haiha-ux/pcb-sample-preamp/renders/pcb_3d_bottom.png

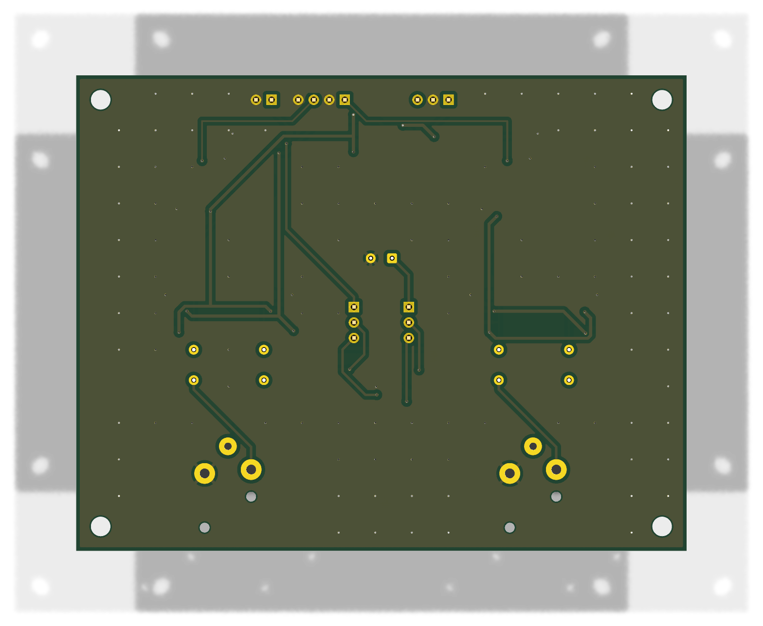
renders/pcb_3d_bottom.png
