haiha-ux/pcb-sample-preamp/renders/pcb_3d_top.png

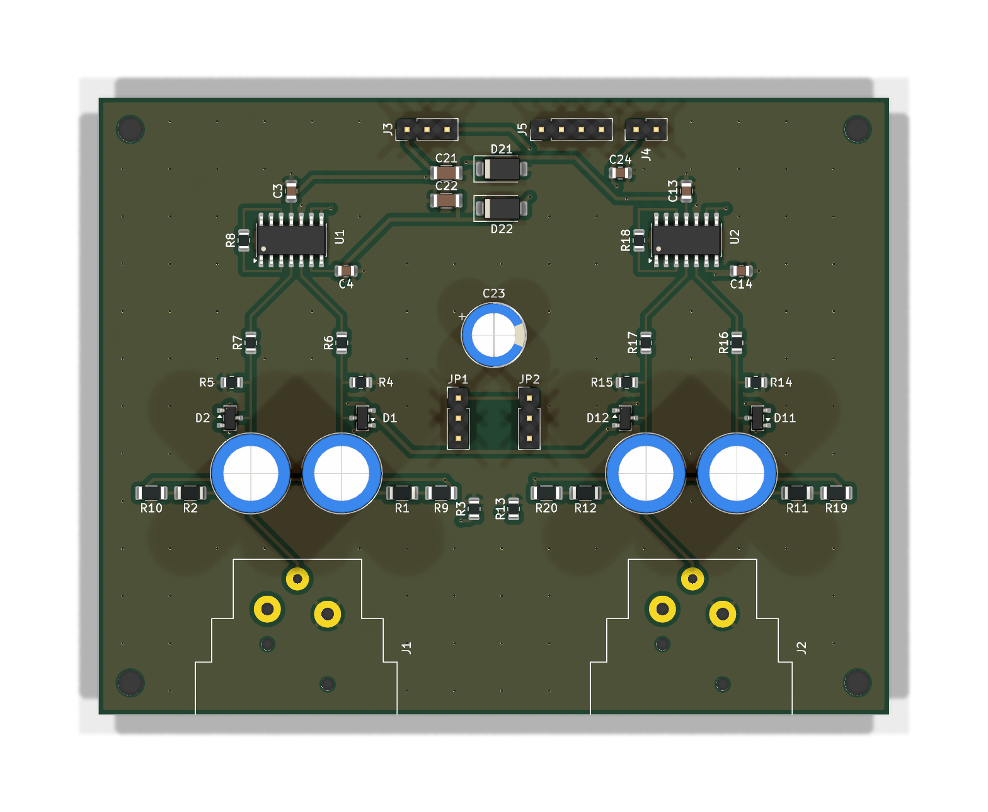
renders/pcb_3d_top.png
