haiha-ux/pcb-sample-preamp/fab/mic_preamp_2ch-BOM.csv

Designator | Value | Footprint | Manufacturer | MPN | LCSC | Spec | Qty
C1,C2,C11,C12 | 47u 63V NP | Capacitor_THT:C_Radial_D10.0mm_H20.0mm_P5.00mm | Nichicon | UVP1J470MPD | not stocked (DigiKey) | 47uF 63V bi-polar D10x17.5 P5.0; alt Cornell Dubilier 476BPS063M | 4
C3,C4,C13,C14 | 100n | Capacitor_SMD:C_0805_2012Metric | YAGEO | CC0805KRX7R9BB104 | C49678 | 100nF 50V X7R 0805 | 4
C21,C22 | 10u 25V | Capacitor_SMD:C_1206_3216Metric | Samsung Electro-Mechanics | CL31B106KAHNNNE | C14860 | 10uF 25V X7R 1206 | 2
C23 | 47u 100V | Capacitor_THT:CP_Radial_D8.0mm_P3.50mm | NJCON | 4701010812R00 | C5373423 | 47uF 100V D8x12 P3.5 | 1
C24 | 100n 100V | Capacitor_SMD:C_0805_2012Metric | Samsung Electro-Mechanics | CL21B104KCFNNNE | C28233 | 100nF 100V X7R 0805 | 1
D1,D2,D11,D12 | BAV99 | Package_TO_SOT_SMD:SOT-23 | Nexperia | BAV99,215 | C2500 |  | 4
D21,D22 | SMAJ16A | Diode_SMD:D_SMA | Littelfuse | SMAJ16A | C74561 | TVS 16V standoff, 26V clamp, 400W, rail clamp for P48 hot-plug | 2
H1-H4 | M3 | MountingHole:MountingHole_3.2mm_M3 |  |  |  |  | 4
J1,J2 | NC3FAH1 | Connector_Audio:Jack_XLR_Neutrik_NC3FAH1_Horizontal | Neutrik | NC3FAH1 | C368476 |  | 2
J3 | PWR +15/GND/-15 | Connector_PinHeader_2.54mm:PinHeader_1x03_P2.54mm_Vertical | Molex | 22284030 | C587036 |  | 1
J4 | P48 +48/GND | Connector_PinHeader_2.54mm:PinHeader_1x02_P2.54mm_Vertical | Molex | 22284020 | C234182 |  | 1
J5 | OUT1/GND/OUT2/GND | Connector_PinHeader_2.54mm:PinHeader_1x04_P2.54mm_Vertical | Molex | 22284040 | C587039 |  | 1
JP1,JP2 | P48 ON=1-2 OFF=2-3 | Connector_PinHeader_2.54mm:PinHeader_1x03_P2.54mm_Vertical | Molex | 22284030 | C587036 | 1x3 2.54mm 500V + shunt Sullins SPC02SYAN (LCSC C6297395) | 2
R1,R2,R9-R12,R19,R20 | 3.40k | Resistor_SMD:R_1206_3216Metric | YAGEO | RT1206BRD073K4L | C870711 | 3.40k 0.1% 25ppm thin film 1206 0.25W 200V; 2 in series per leg = 6.80k | 8
R3,R13 | 47k | Resistor_SMD:R_0805_2012Metric | UNI-ROYAL | 0805W8F4702T5E | C17713 | 47k 1% 0805 150V | 2
R4,R5,R14,R15 | 2.2k | Resistor_SMD:R_0805_2012Metric | YAGEO | RT0805BRD072K2L | C865371 | 2.2k 0.1% 25ppm thin film 0805 | 4
R6,R7,R16,R17 | 10R | Resistor_SMD:R_0805_2012Metric | SIE | CRF0805Q10R0BN | C55205321 | 10R 0.1% thin film 0805 | 4
R8,R18 | 60.4R | Resistor_SMD:R_0805_2012Metric | FOJAN | FRC0805F60R4TS | C2933479 | 60.4R 1% 0805 (G=100) | 2
U1,U2 | INA163UA | Package_SO:SOIC-14_3.9x8.7mm_P1.27mm | Texas Instruments | INA163UA | C2868965 |  | 2
