haiha-ux/pcb-sample-preamp/(list of files, drawings)

Other design files:
reports/route.dsn
