haiha-ux/pcb-sample-preamp/mic_preamp_2ch.kicad_pcb

## KiCad design mic_preamp_2ch.kicad_pcb (2026-10-30)

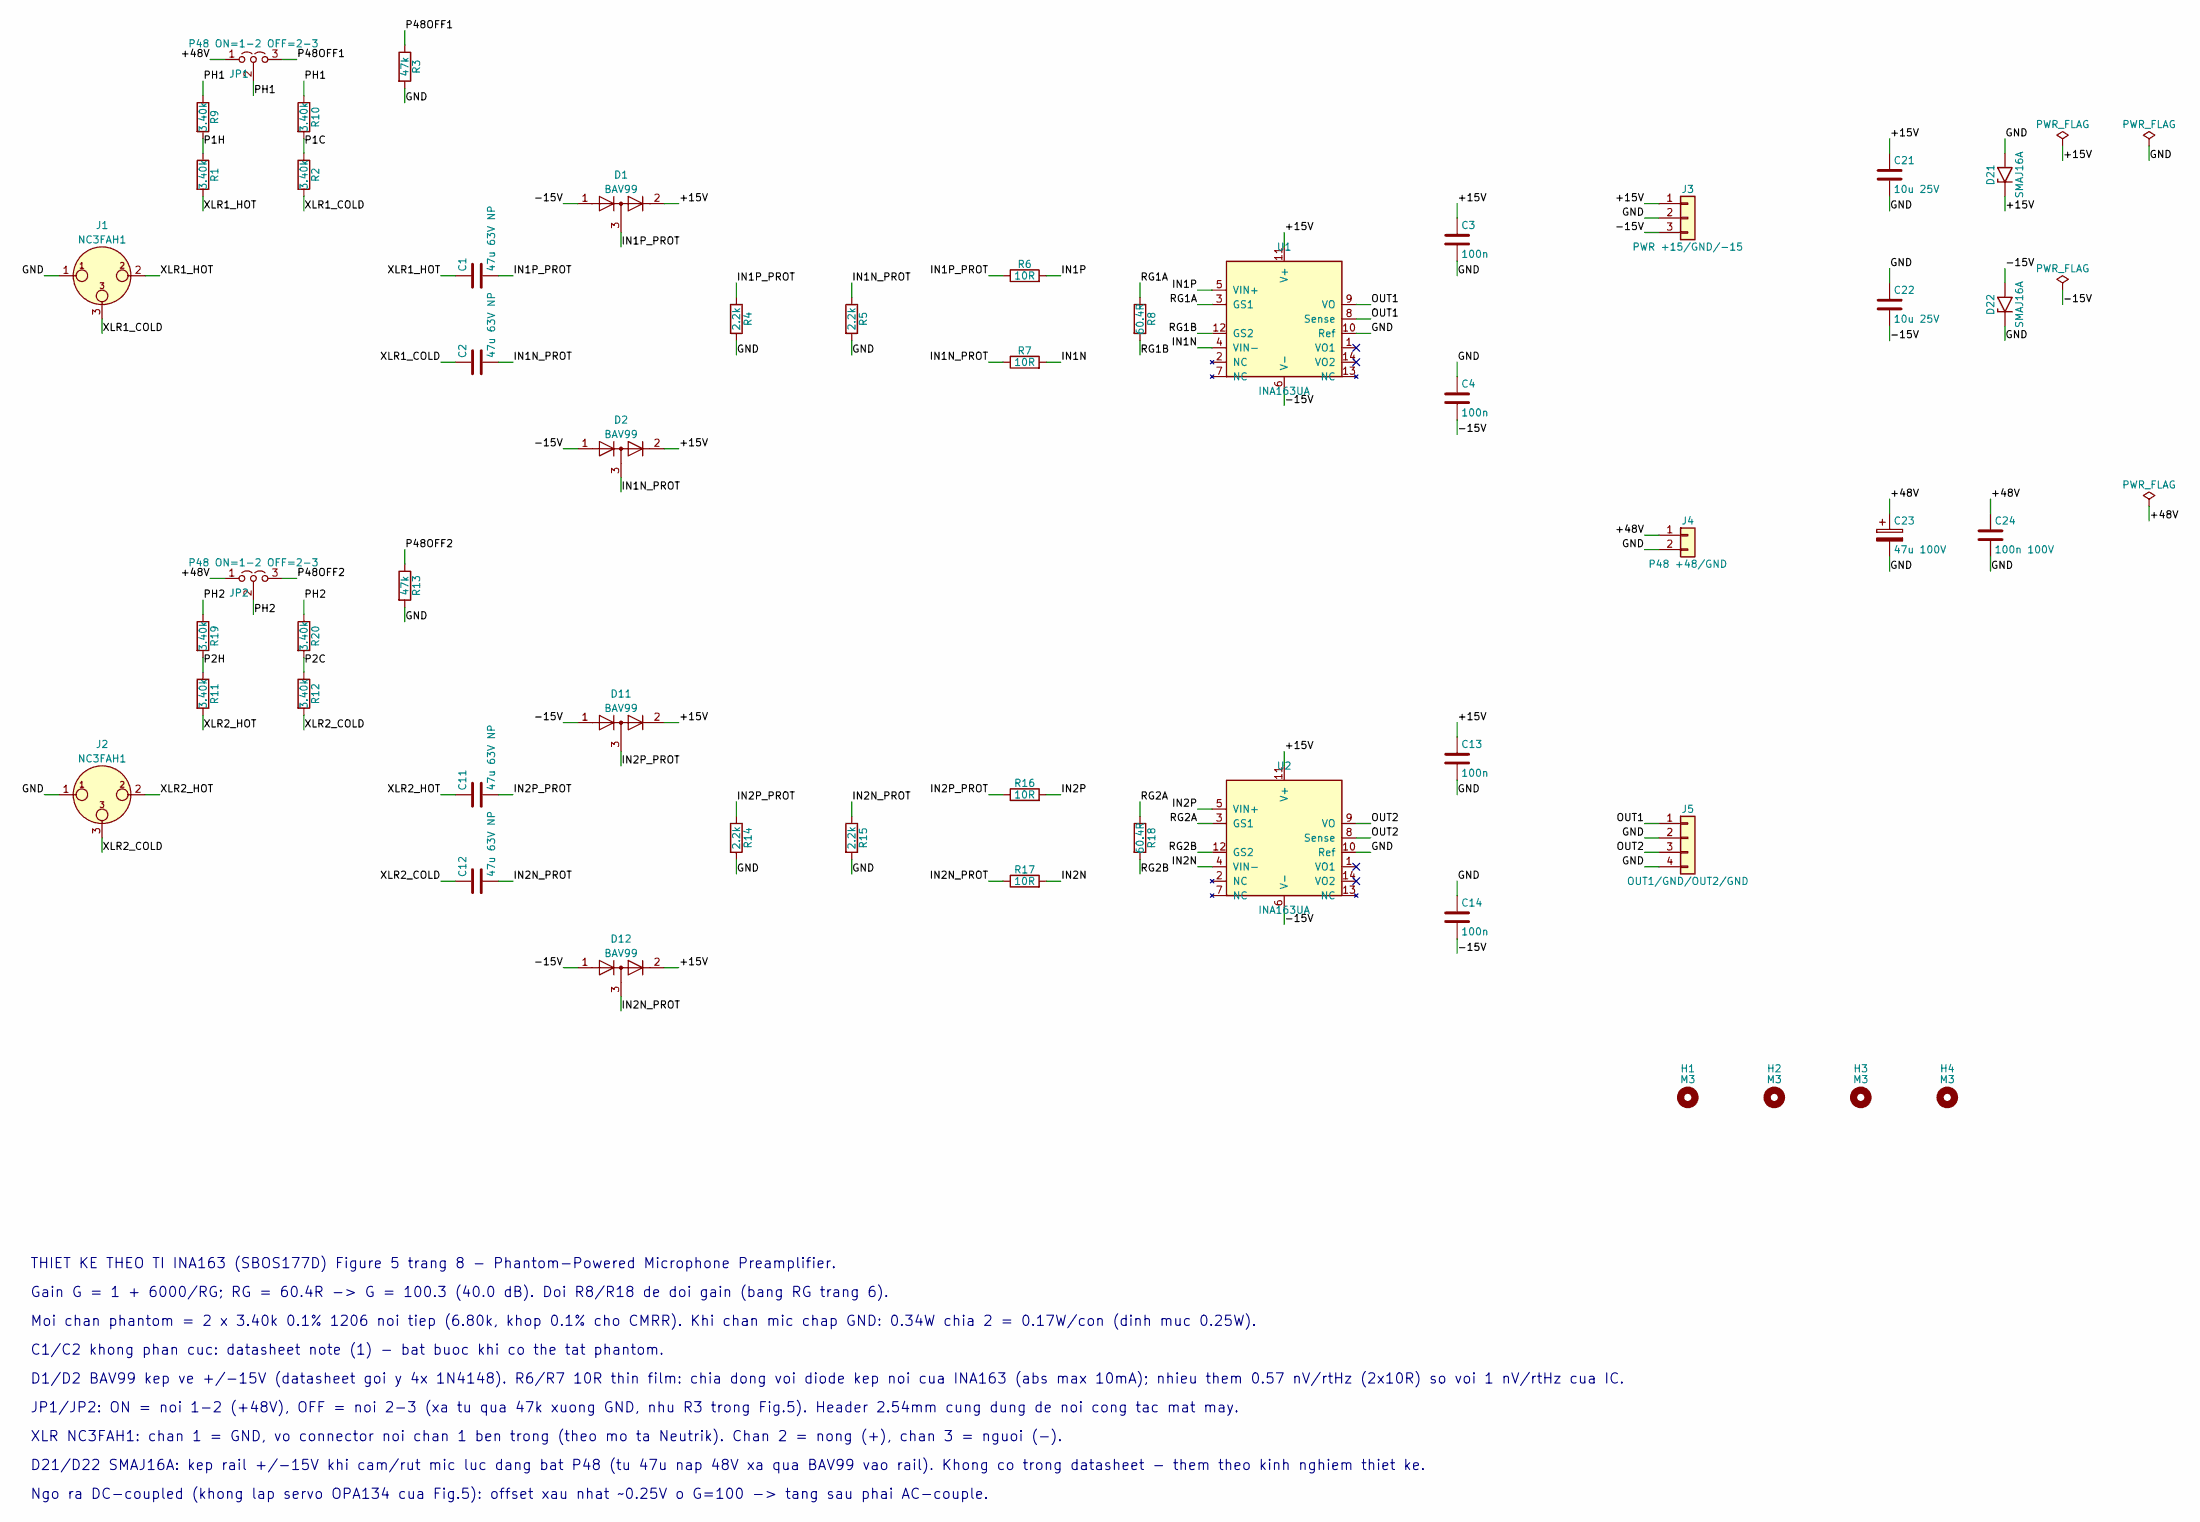
[picture p7: schematic mic_preamp_2ch.kicad_sch]

Parts:
C1, C2, C11, C12: 47u 63V NP; C_Radial_D10.0mm_H20.0mm_P5.00mm; MPN UVP1J470MPD; LCSC not stocked (DigiKey)
C3, C4, C13, C14: 100n; C_0805_2012Metric; MPN CC0805KRX7R9BB104; LCSC C49678
C21, C22: 10u 25V; C_1206_3216Metric; MPN CL31B106KAHNNNE; LCSC C14860
C23: 47u 100V; CP_Radial_D8.0mm_P3.50mm; MPN 4701010812R00; LCSC C5373423
C24: 100n 100V; C_0805_2012Metric; MPN CL21B104KCFNNNE; LCSC C28233
D1, D2, D11, D12: BAV99; SOT-23; MPN BAV99,215; LCSC C2500
D21, D22: SMAJ16A; D_SMA; MPN SMAJ16A; LCSC C74561
H1, H2, H3, H4: M3; MountingHole_3.2mm_M3
J1, J2: NC3FAH1; Jack_XLR_Neutrik_NC3FAH1_Horizontal; MPN NC3FAH1; LCSC C368476
J3: PWR +15/GND/-15; PinHeader_1x03_P2.54mm_Vertical; MPN 22284030; LCSC C587036
J4: P48 +48/GND; PinHeader_1x02_P2.54mm_Vertical; MPN 22284020; LCSC C234182
J5: OUT1/GND/OUT2/GND; PinHeader_1x04_P2.54mm_Vertical; MPN 22284040; LCSC C587039
JP1, JP2: P48 ON=1-2 OFF=2-3; PinHeader_1x03_P2.54mm_Vertical; MPN 22284030; LCSC C587036
R1, R2, R9, R10, R11, R12, R19, R20: 3.40k; R_1206_3216Metric; MPN RT1206BRD073K4L; LCSC C870711
R3, R13: 47k; R_0805_2012Metric; MPN 0805W8F4702T5E; LCSC C17713
R4, R5, R14, R15: 2.2k; R_0805_2012Metric; MPN RT0805BRD072K2L; LCSC C865371
R6, R7, R16, R17: 10R; R_0805_2012Metric; MPN CRF0805Q10R0BN; LCSC C55205321
R8, R18: 60.4R; R_0805_2012Metric; MPN FRC0805F60R4TS; LCSC C2933479
U1, U2: INA163UA; SOIC-14_3.9x8.7mm_P1.27mm; MPN INA163UA; LCSC C2868965

Connections:
/+15V: C3.1, C13.1, C21.1, D1.2 (A), D2.2 (A), D11.2 (A), D12.2 (A), D21.1 (A1), J3.1, U1.11 (V+), U2.11 (V+)
/+48V: C23.1, C24.1, J4.1, JP1.1 (A), JP2.1 (A)
/-15V: C4.2, C14.2, C22.2, D1.1 (K), D2.1 (K), D11.1 (K), D12.1 (K), D22.2 (A2), J3.3, U1.6 (V-), U2.6 (V-)
/GND: C3.2, C4.1, C13.2, C14.1, C21.2, C22.1, C23.2, C24.2, D21.2 (A2), D22.1 (A1), J1.1, J2.1, J3.2, J4.2, J5.2, J5.4, R3.2, R4.2, R5.2, R13.2, R14.2, R15.2, U1.10 (Ref), U2.10 (Ref)
/IN1N: R7.2, U1.4 (VIN-)
/IN1N_PROT: C2.2, D2.3 (K), R5.1, R7.1
/IN1P: R6.2, U1.5 (VIN+)
/IN1P_PROT: C1.2, D1.3 (K), R4.1, R6.1
/IN2N: R17.2, U2.4 (VIN-)
/IN2N_PROT: C12.2, D12.3 (K), R15.1, R17.1
/IN2P: R16.2, U2.5 (VIN+)
/IN2P_PROT: C11.2, D11.3 (K), R14.1, R16.1
/OUT1: J5.1, U1.8 (Sense), U1.9 (VO)
/OUT2: J5.3, U2.8 (Sense), U2.9 (VO)
/P1C: R2.1, R10.2
/P1H: R1.1, R9.2
/P2C: R12.1, R20.2
/P2H: R11.1, R19.2
/P48OFF1: JP1.3 (B), R3.1
/P48OFF2: JP2.3 (B), R13.1
/PH1: JP1.2 (C), R9.1, R10.1
/PH2: JP2.2 (C), R19.1, R20.1
/RG1A: R8.1, U1.3 (GS1)
/RG1B: R8.2, U1.12 (GS2)
/RG2A: R18.1, U2.3 (GS1)
/RG2B: R18.2, U2.12 (GS2)
/XLR1_COLD: C2.1, J1.3, R2.2
/XLR1_HOT: C1.1, J1.2, R1.2
/XLR2_COLD: C12.1, J2.3, R12.2
/XLR2_HOT: C11.1, J2.2, R11.2

Notes on the sheet:
THIET KE THEO TI INA163 (SBOS177D) Figure 5 trang 8 - Phantom-Powered Microphone Preamplifier.
Gain G = 1 + 6000/RG; RG = 60.4R -> G = 100.3 (40.0 dB). Doi R8/R18 de doi gain (bang RG trang 6).
Moi chan phantom = 2 x 3.40k 0.1% 1206 noi tiep (6.80k, khop 0.1% cho CMRR). Khi chan mic chap GND: 0.34W chia 2 = 0.17W/con (dinh muc 0.25W).
C1/C2 khong phan cuc: datasheet note (1) - bat buoc khi co the tat phantom.
D1/D2 BAV99 kep ve +/-15V (datasheet goi y 4x 1N4148). R6/R7 10R thin film: chia dong voi diode kep noi cua INA163 (abs max 10mA); nhieu them 0.57 nV/rtHz (2x10R) so voi 1 nV/rtHz cua IC.
JP1/JP2: ON = noi 1-2 (+48V), OFF = noi 2-3 (xa tu qua 47k xuong GND, nhu R3 trong Fig.5). Header 2.54mm cung dung de noi cong tac mat may.
XLR NC3FAH1: chan 1 = GND, vo connector noi chan 1 ben trong (theo mo ta Neutrik). Chan 2 = nong (+), chan 3 = nguoi (-).
D21/D22 SMAJ16A: kep rail +/-15V khi cam/rut mic luc dang bat P48 (tu 47u nap 48V xa qua BAV99 vao rail). Khong co trong datasheet - them theo kinh nghiem thiet ke.
Ngo ra DC-coupled (khong lap servo OPA134 cua Fig.5): offset xau nhat ~0.25V o G=100 -> tang sau phai AC-couple.

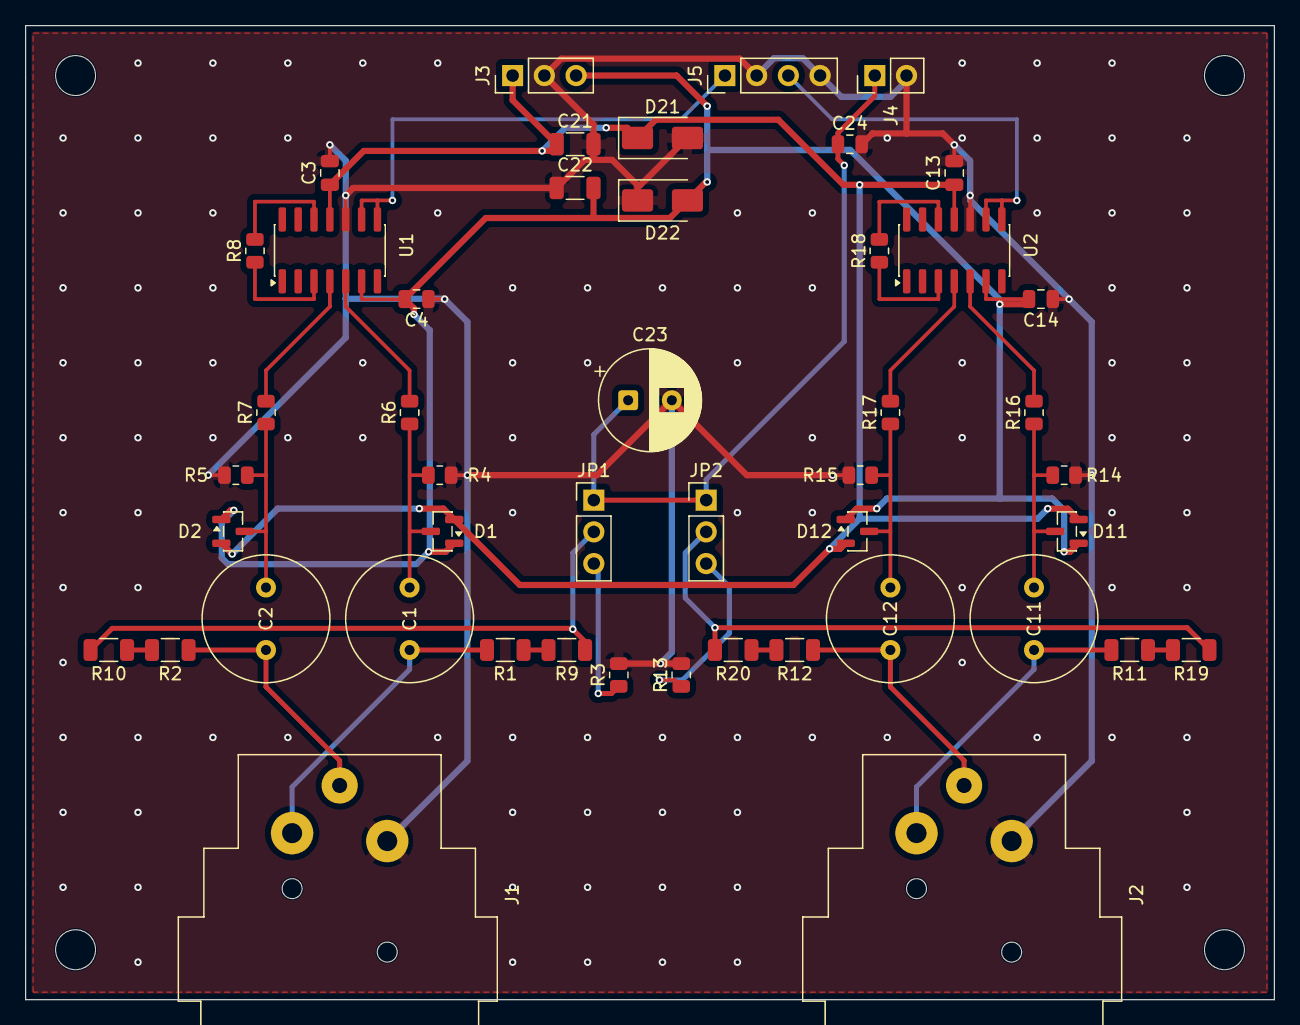
[picture p8: board mic_preamp_2ch.kicad_pcb from above]

Board: 2 copper layers, 100.0 x 78.0 mm, 51 parts (0 on the bottom side), 30 nets.
