haiha-ux/pcb-sample-preamp/(commit log)

2026-10-30 2-channel phantom-powered mic preamp (INA163) - KiCad sample
    Schematic + 2-layer routed PCB, raw ERC/DRC reports, schematic PDF,
    renders, BOM with MPNs, CPL and Gerber/drill. Built from scripts in tools/.
    [mic_preamp_2ch-BOM.csv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]
2026-10-30 v2: hand-routed symmetric input path, 0.1% matched parts, 10R series
    Fixes the review of efc1e58: the 47R series resistors were a misreading of
    datasheet Fig.2 (47R is in parallel with 1.2uH there) and doubled input noise.
    Phantom feed is now 2x3.40k 0.1% per leg, bias 2.2k 0.1%, series 10R.
    Input legs are routed by hand and locked; only power/phantom/GND autorouted.
    [mic_preamp_2ch-BOM.csv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]
2026-10-30 README: note independent KiCad 10.0.8 re-verification and v3 ground-slot item
2026-10-30 README: tighten wording
